DinoLeung/can-pulse/src/main.cpp

#include <Arduino.h>
#include "can_bus.h"
#include "gps.h"
#include "rc_ble.h"
// #include "sensor_tasks.h"
#include "can_tasks.h"
#include "gps_tasks.h"
#include "rc_ble_tasks.h"

void setup() {
	initCanBus();
	initGps();
	initRaceChronoBle();
	
	startCanTasks(0);
	startGpsTasks(1);
	// startSensorTasks();
	startRaceChronoTasks();
}

void loop() { /* DO NOTHING */ }
