DinoLeung/can-pulse/(commit log)

2026-03-31 optimise can notify task, notifying at 300hz avg
2026-04-17 pin critical tasks to core
2026-04-18 remove serial prints
2026-04-20 added bom table
2026-05-19 added wiring tables, added wip openscad
    [sup500f_enclosure.scad]
